r00takaspin/esp32/(commit log)

2026-10-21 esp32 initial
2026-10-25 Перевод проекта на TOTP: чистка старых скетчей
2026-10-29 подключена кнопка ky040
2026-10-29 прошивка секретов по wifi
2026-10-29 docs: add KY-040 wiring diagram and link button to schematic
2026-10-29 Add full peripheral wiring diagram, remove obsolete migration scripts
